BG4444/RS485-dry-contact/RS485-dry-contact.kicad_pcb

## KiCad design RS485-dry-contact.kicad_pcb (2015-04-13)

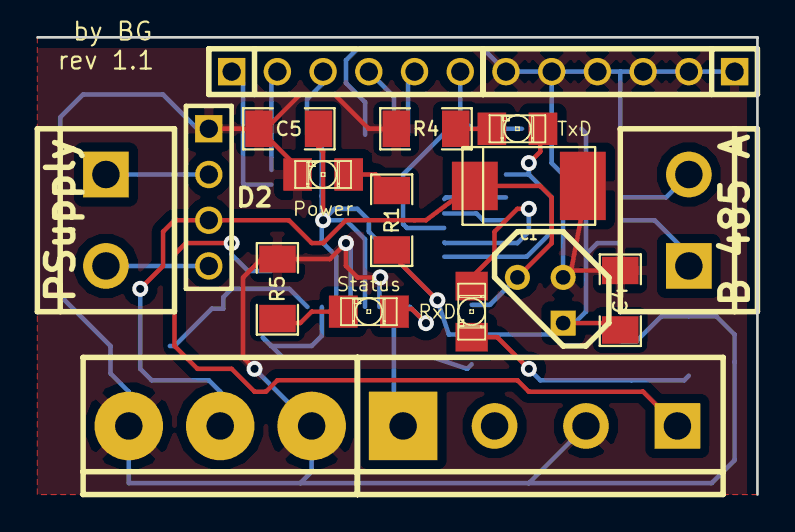
[picture p1: board RS485-dry-contact.kicad_pcb from above]

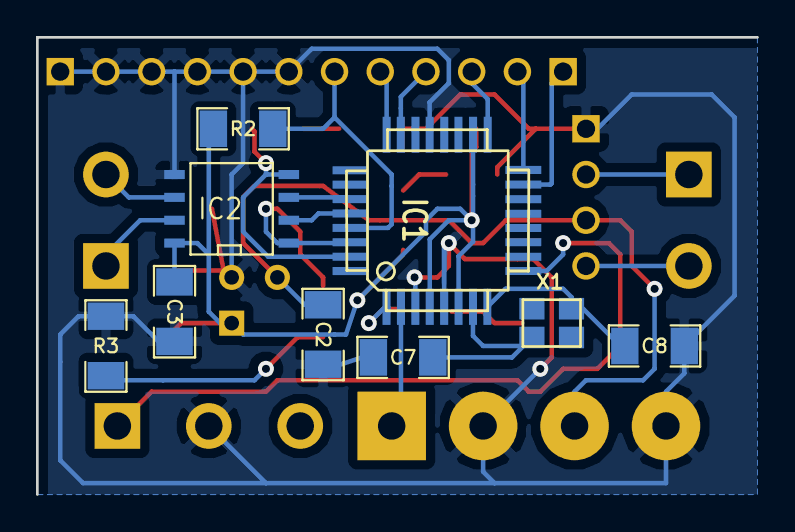
[picture p2: board RS485-dry-contact.kicad_pcb from below]

Board: 2 copper layers, 40.0 x 25.4 mm, 16 parts (9 on the bottom side), 10 nets.

Parts:
C1: c_tant_D
C2, C3, C4, C5, C7, C8: SM1206
D2: PIN_ARRAY_4x1
IC1: TQFP32
IC2: SO8N
R1, R2, R3, R4, R5: SM1206
X1: crystal_FA238-TSX3225

Connections:
GND: C1.2, C2.1, C3.1, C4.2, C5.2, C7.1, C8.1, D2.1, IC1.3, IC1.5, IC1.21, IC2.5, R3.2, R4.2, R5.2
unnamed: IC1.29, R2.1
unnamed: IC1.30, IC2.1
unnamed: IC1.31, IC2.4
unnamed: IC1.28, IC2.2
unnamed: IC1.27, IC2.3
unnamed: C1.1, C2.2, D2.3
unnamed: C8.2, IC1.8, X1.2
unnamed: C7.2, IC1.7, X1.1
VCC: C3.2, C4.1, C5.1, IC1.4, IC1.6, IC1.18, IC2.8, R1.2, R2.2
