BG4444/RS485-dry-contact/(commit log)

2015-04-11 Sceme draft
    [RS485-dry-contact.sch]
2015-04-11 remove arv-isp
    [RS485-dry-contact.kicad_pcb]
2015-04-12 Rev 1.0
    [RS485-dry-contact.kicad_pcb, RS485-dry-contact.sch]
2015-04-13 Rev 1.1
    [$RS485-dry-contact.sch, RS485-dry-contact.kicad_pcb]
2015-04-14 Add Gerbers
    [Bottom.gbl, Drill.drl, Silk_Bottom.gbo, Silk_Top.gto, Top.gtl]
2015-04-14 Add Masks
    [RS485-dry-contact-B_Mask.gbs, RS485-dry-contact-F_Mask.gts]
2015-04-20 Добавлен список компонентов
    [RS485-dry-contact.csv, RS485-dry-contact.sch]
2015-05-03 First try to detect collision
    [hal.c, hal.h]
